Delph/RF-Domination/assets/Domination circuitry.jpg

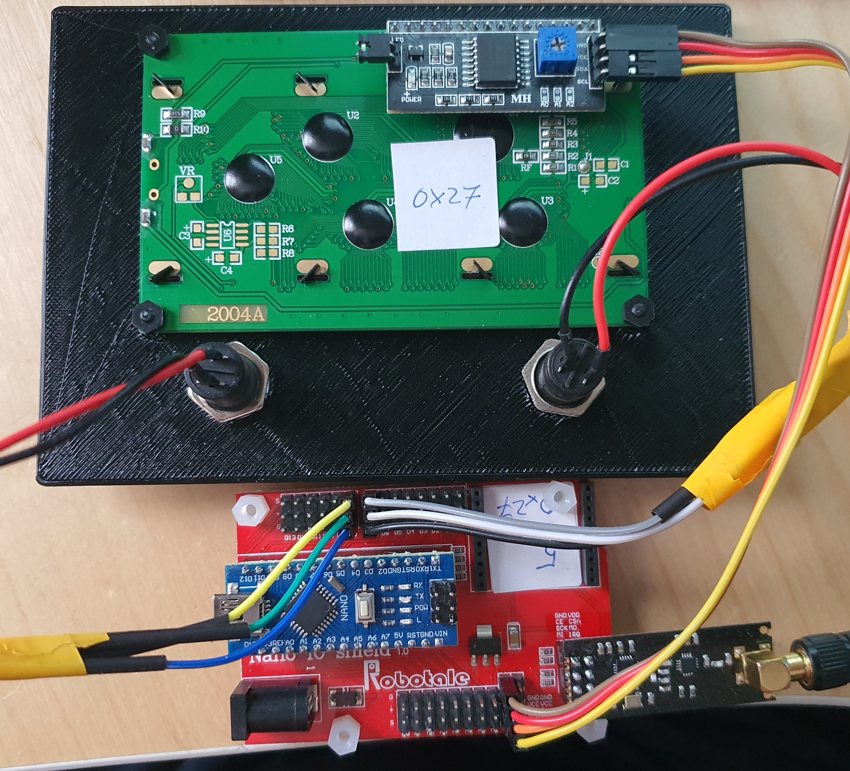
assets/Domination circuitry.jpg
