Delph/RF-Domination/assets/shield.jpg

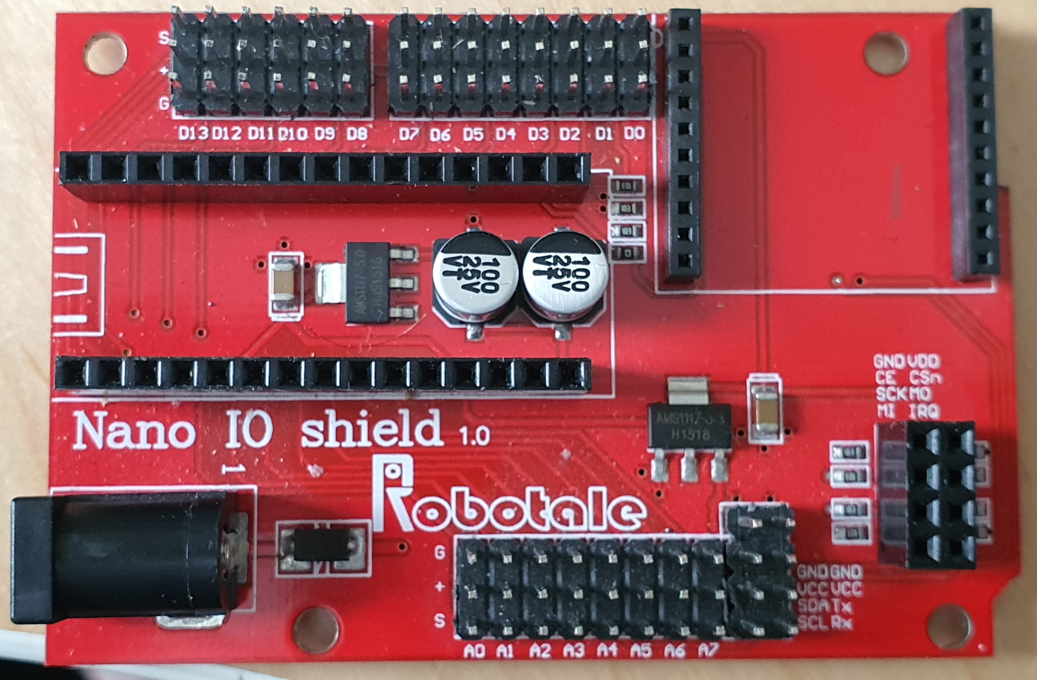
assets/shield.jpg
