Delph/RF-Domination/assets/3d Files/Domination Box Lid.stl

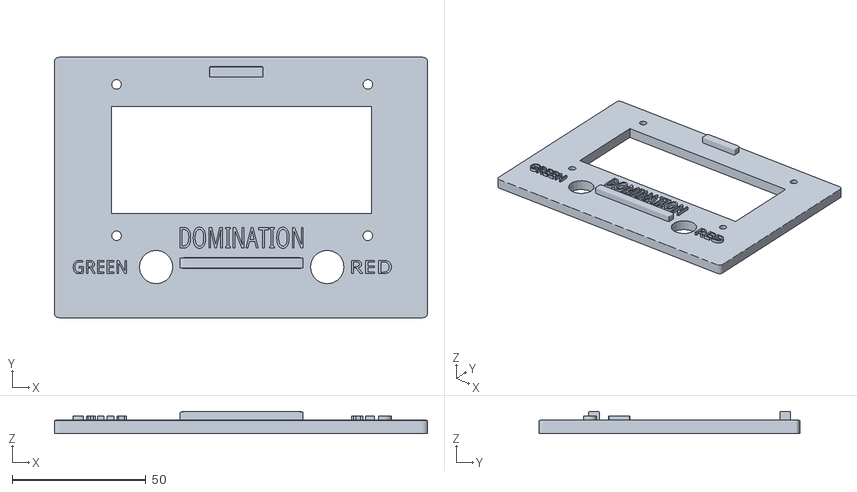
[picture p4: CAD file, 2020-04-25]
assets/3d Files/Domination Box Lid.stl
139.5 x 97.5 x 8.25
