Delph/RF-Domination/assets/3d Files/Domination Base.stl

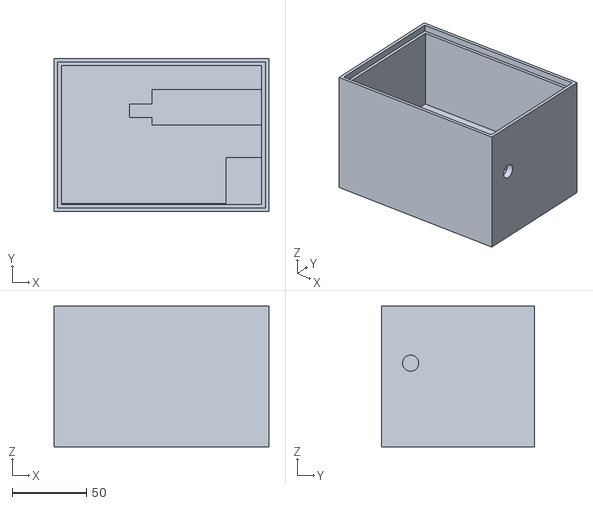
[picture p5: CAD file, 2020-04-25]
assets/3d Files/Domination Base.stl
145.0 x 103.5 x 95.0
